JacobsFarm/sow_machine/CAD_design/stepper_motor/previews/4_from_below.png

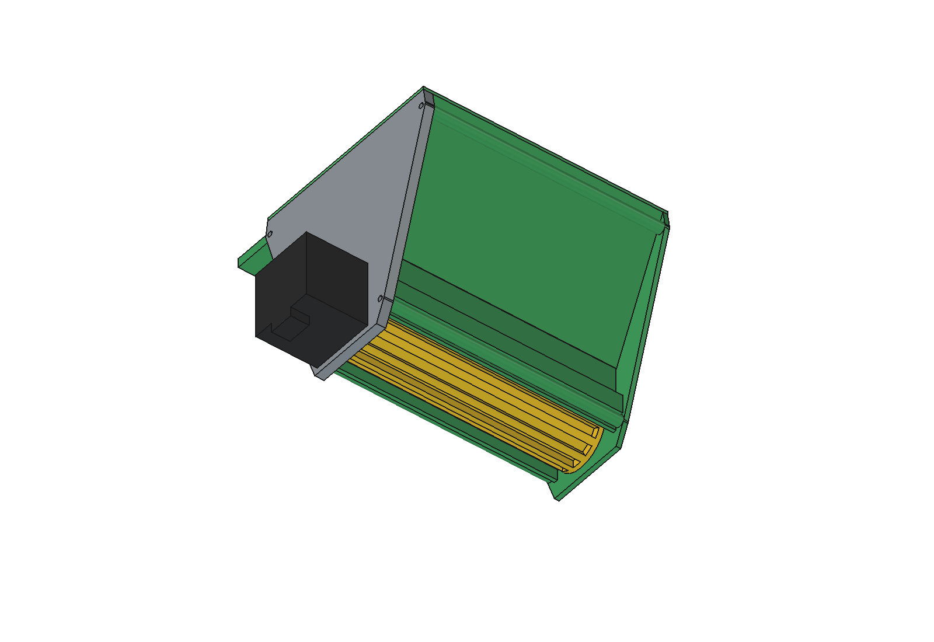
CAD_design/stepper_motor/previews/4_from_below.png
