JacobsFarm/sow_machine/CAD_design/TT-motor/previews/image-1792515938362.png

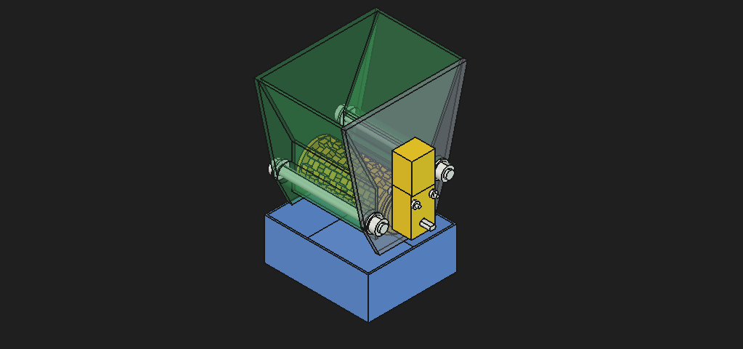
CAD_design/TT-motor/previews/image-1792515938362.png
