JacobsFarm/sow_machine/CAD_design/stepper_motor/Overseeder_Mini_Print.step

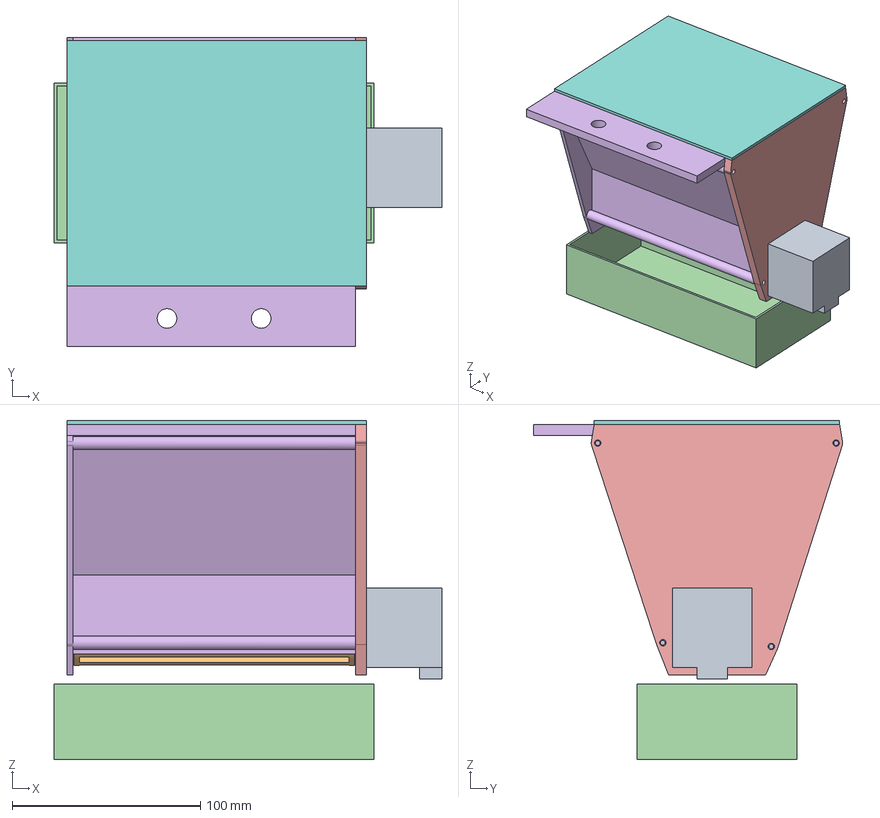
[picture p16: CAD file, 2026-10-20]
CAD_design/stepper_motor/Overseeder_Mini_Print.step
206.0 x 164.3 x 180.0 mm
stepper_NEMA17_42x40
fluted_roller_D40_12_flutes_PETG
stepper_shaft_D5
catch_tray_PETG
motor_plate_PETG
hopper_body_PETG
cutoff_rim_PETG
lid_PETG
