JacobsFarm/sow_machine/CAD_design/TT-motor/Overseeder_Mini_TT.step

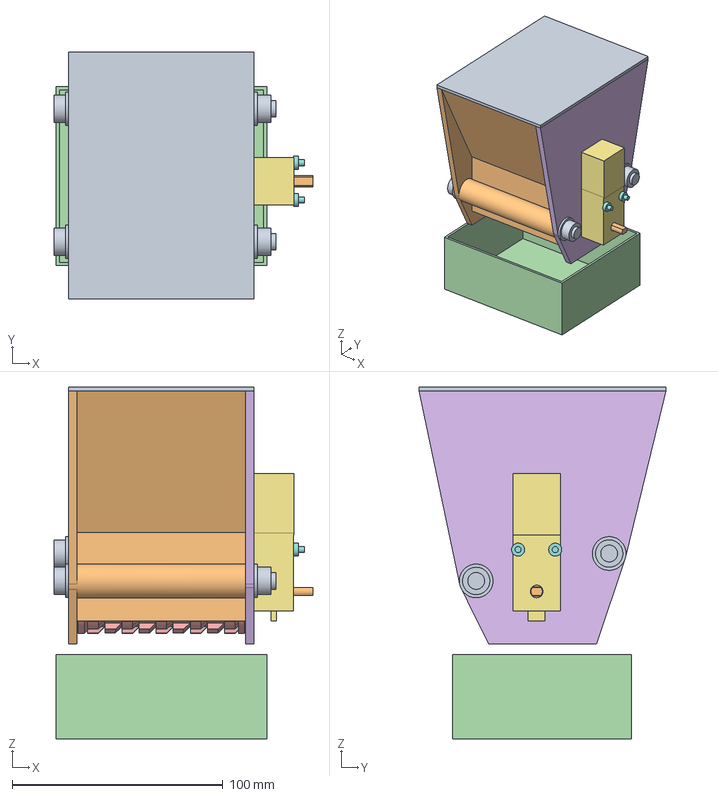
[picture p18: CAD file, 2026-10-20]
CAD_design/TT-motor/Overseeder_Mini_TT.step
122.8 x 117.1 x 167.0 mm
lid_PETG
TT_shaft_5.4_DD_3.7
cutoff_rim_PETG
catch_tray_PETG
cam_roller_F_TT_PETG
motor_plate_TT_PETG
TT_gear_motor_1to48
motor_bolts_M3x25_nuts
bolt_M8x100_washers_nut
hopper_body_PETG
