JacobsFarm/sow_machine/CAD_design/TT-motor/stl/ovt_roller_F.stl

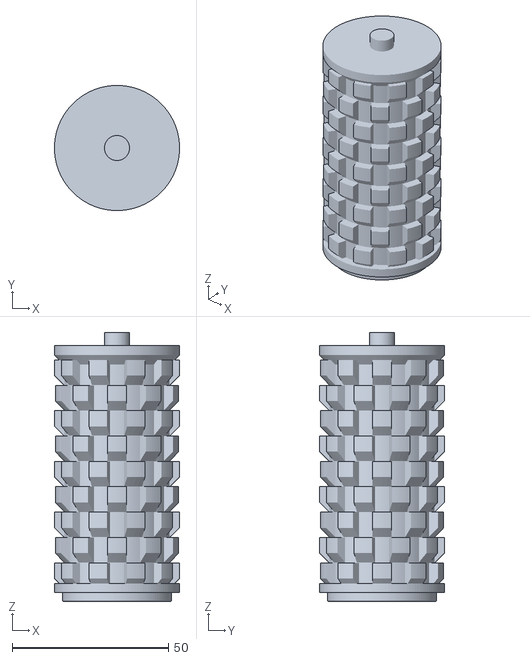
[picture p19: CAD file, 2026-10-20]
CAD_design/TT-motor/stl/ovt_roller_F.stl
40.0 x 40.0 x 86.0
