JacobsFarm/sow_machine/code/TT-motor/app/models/rim.stl

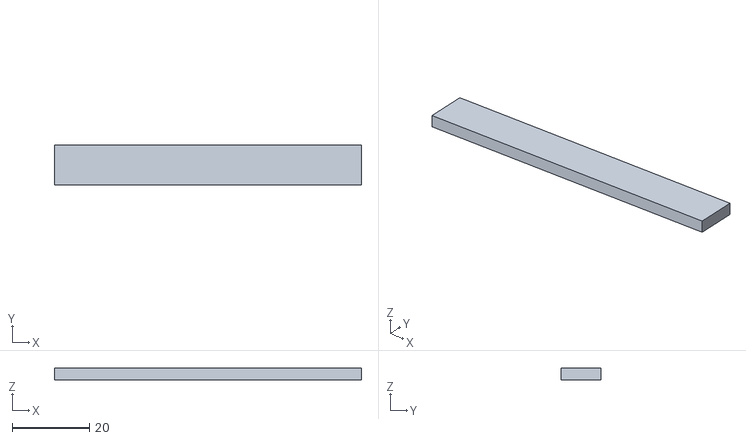
[picture p20: CAD file, 2026-10-20]
code/TT-motor/app/models/rim.stl
79.6 x 10.5 x 3.00
