JacobsFarm/sow_machine/code/TT-motor/app/models/roller_E.stl

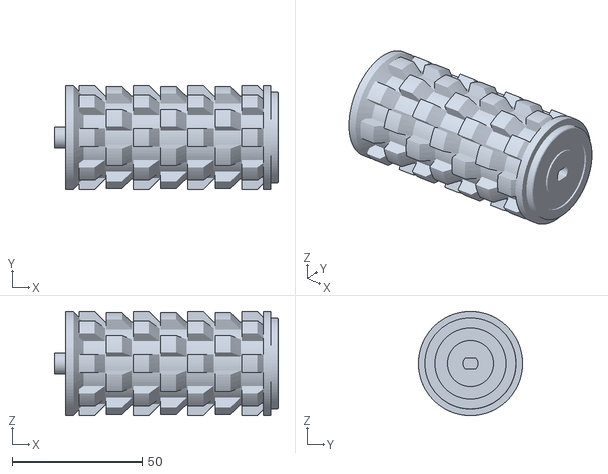
[picture p22: CAD file, 2026-10-20]
code/TT-motor/app/models/roller_E.stl
86.0 x 40.0 x 40.0
