JacobsFarm/sow_machine/CAD_design/stepper_motor/stl/ovm_tray.stl

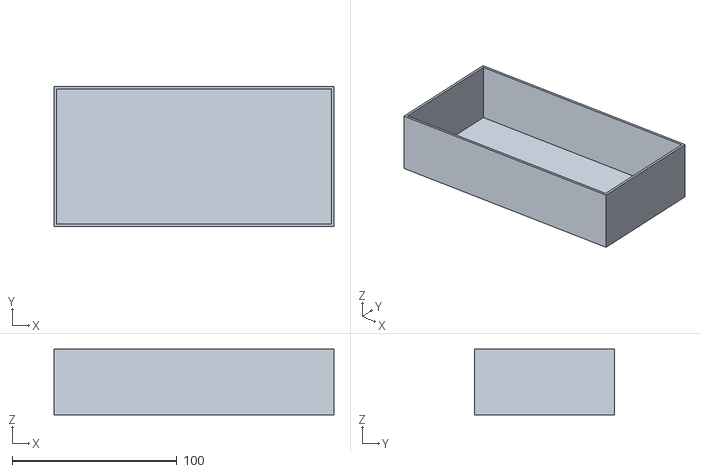
[picture p23: CAD file, 2026-10-20]
CAD_design/stepper_motor/stl/ovm_tray.stl
170.0 x 85.0 x 40.0
