JacobsFarm/sow_machine/CAD_design/stepper_motor/stl/ovm_rim.stl

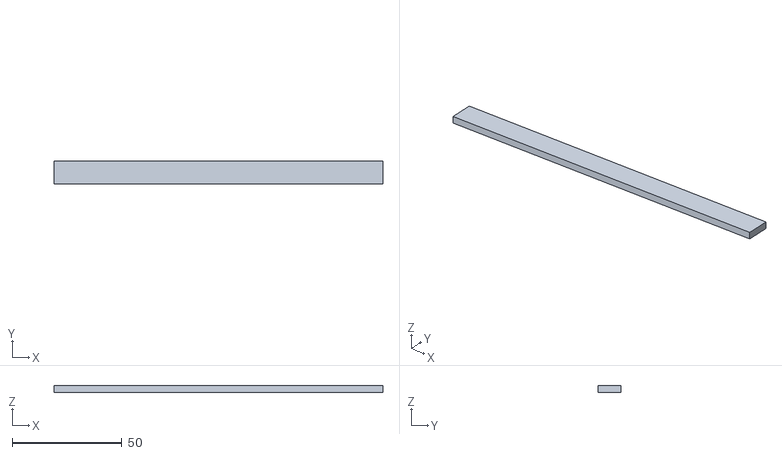
[picture p24: CAD file, 2026-10-20]
CAD_design/stepper_motor/stl/ovm_rim.stl
149.6 x 10.5 x 3.00
