JacobsFarm/sow_machine/CAD_design/TT-motor/stl/ovt_lid.stl

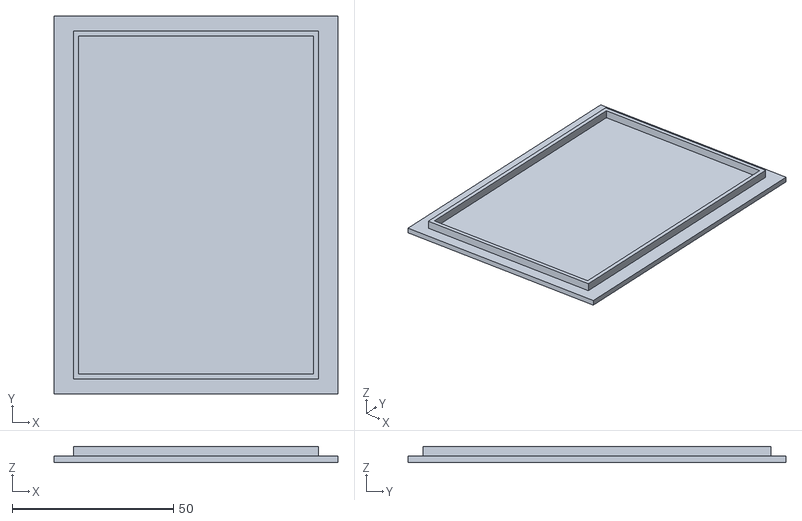
[picture p25: CAD file, 2026-10-20]
CAD_design/TT-motor/stl/ovt_lid.stl
88.0 x 117.1 x 5.00
