JacobsFarm/sow_machine/CAD_design/stepper_motor/stl/ovm_lid.stl

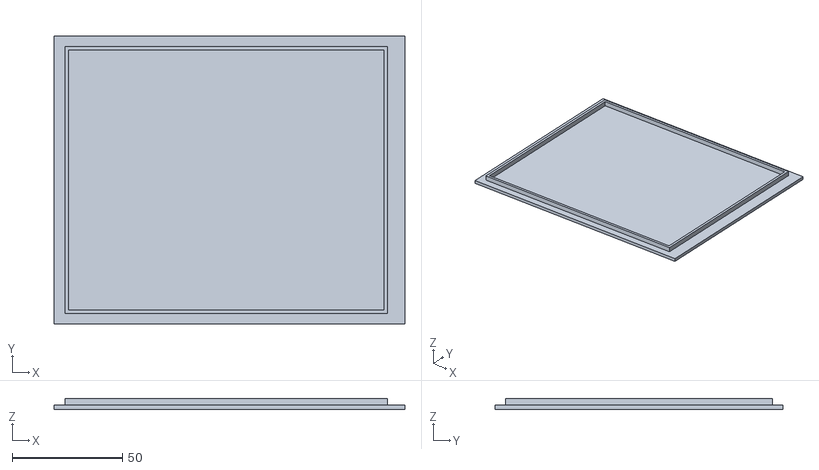
[picture p26: CAD file, 2026-10-20]
CAD_design/stepper_motor/stl/ovm_lid.stl
159.0 x 130.3 x 5.00
