JacobsFarm/sow_machine/CAD_design/stepper_motor/stl/ovm_roller.stl

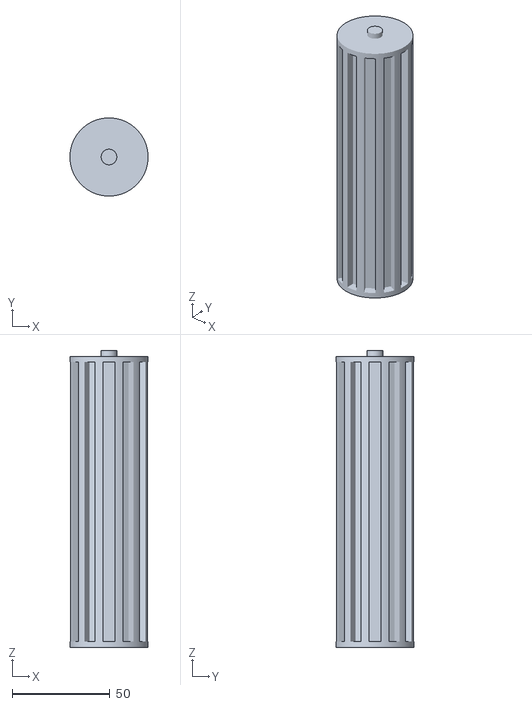
[picture p27: CAD file, 2026-10-20]
CAD_design/stepper_motor/stl/ovm_roller.stl
40.0 x 40.0 x 152.0
