JacobsFarm/sow_machine/CAD_design/stepper_motor/stl/ovm_roller_G.stl

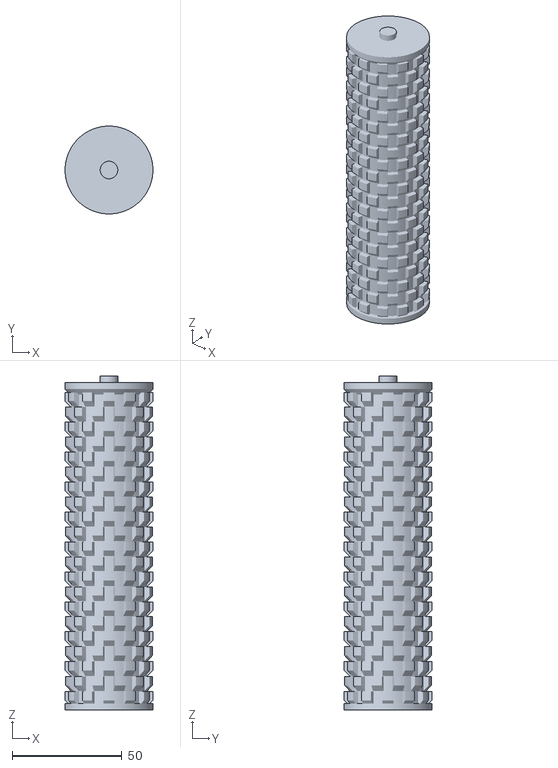
[picture p28: CAD file, 2026-10-20]
CAD_design/stepper_motor/stl/ovm_roller_G.stl
40.0 x 40.0 x 152.0
