JacobsFarm/sow_machine/code/TT-motor/app/models/tt_shaft.stl

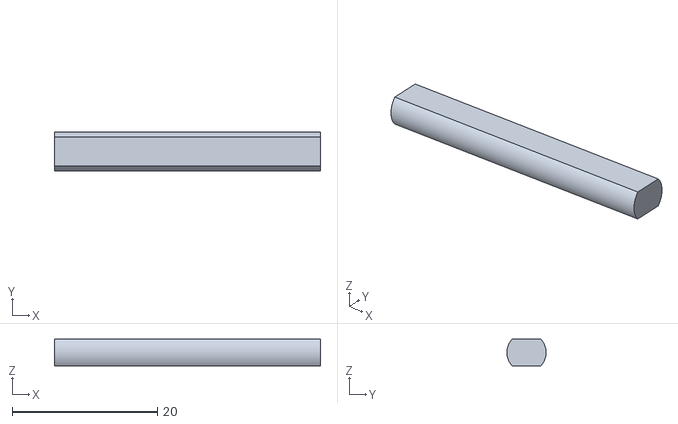
[picture p29: CAD file, 2026-10-20]
code/TT-motor/app/models/tt_shaft.stl
36.6 x 5.40 x 3.70
