JacobsFarm/sow_machine/CAD_design/stepper_motor/stl/ovm_body.stl

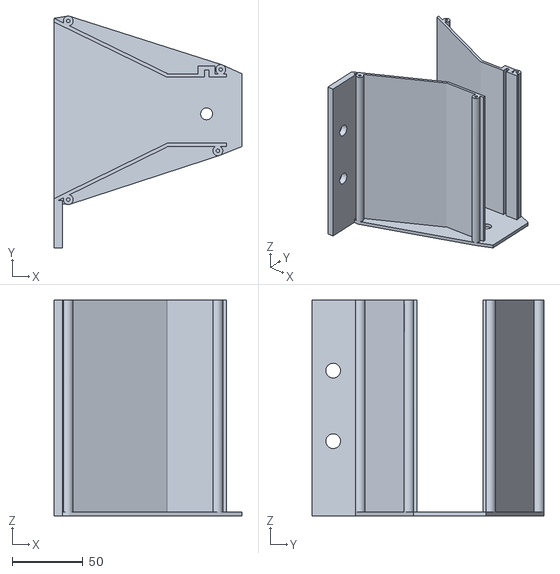
[picture p30: CAD file, 2026-10-20]
CAD_design/stepper_motor/stl/ovm_body.stl
133.0 x 164.3 x 153.0
