JacobsFarm/sow_machine/CAD_design/TT-motor/stl/ovt_tray.stl

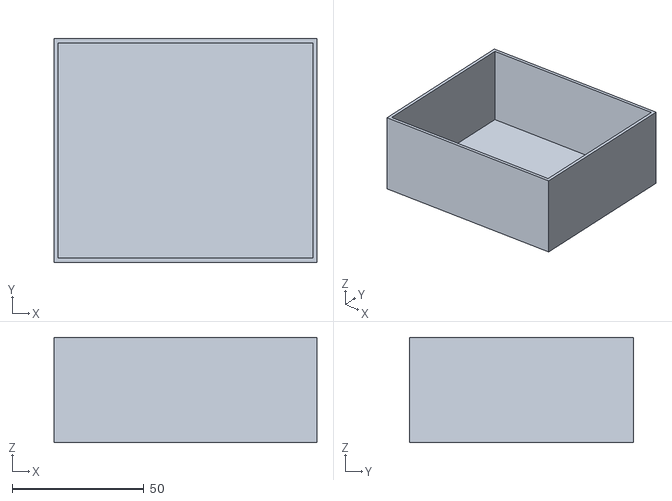
[picture p31: CAD file, 2026-10-20]
CAD_design/TT-motor/stl/ovt_tray.stl
100.0 x 85.0 x 40.0
