JacobsFarm/sow_machine/code/TT-motor/app/models/motor_plate.stl

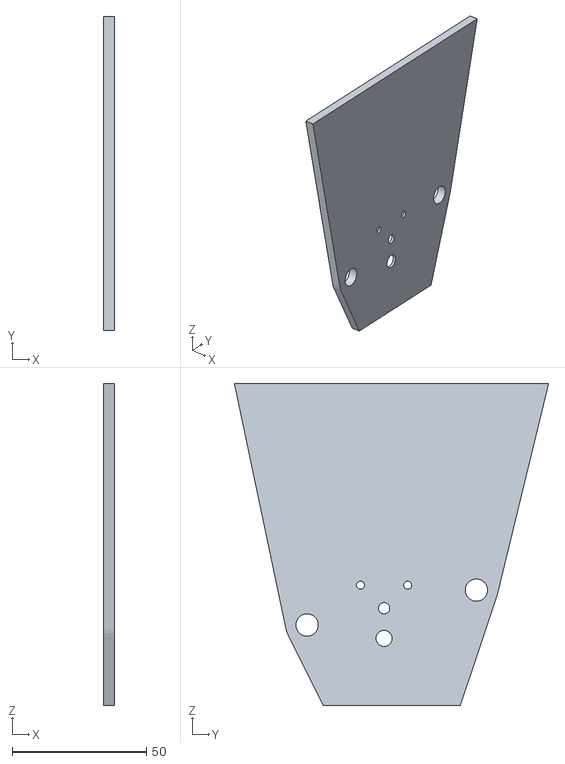
[picture p32: CAD file, 2026-10-20]
code/TT-motor/app/models/motor_plate.stl
4.00 x 117.1 x 120.0
