JacobsFarm/sow_machine/CAD_design/TT-motor/stl/ovt_body.stl

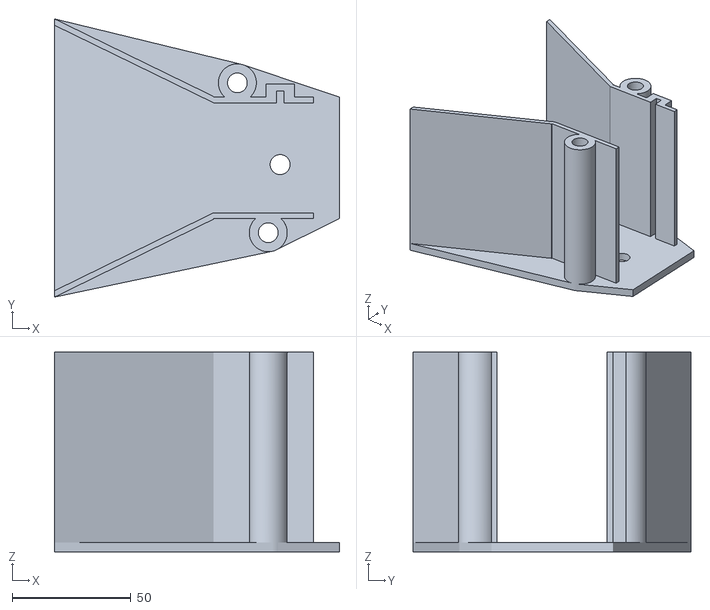
[picture p34: CAD file, 2026-10-20]
CAD_design/TT-motor/stl/ovt_body.stl
120.0 x 117.1 x 84.0
