JacobsFarm/sow_machine/CAD_design/stepper_motor/stl/ovm_motor_plate.stl

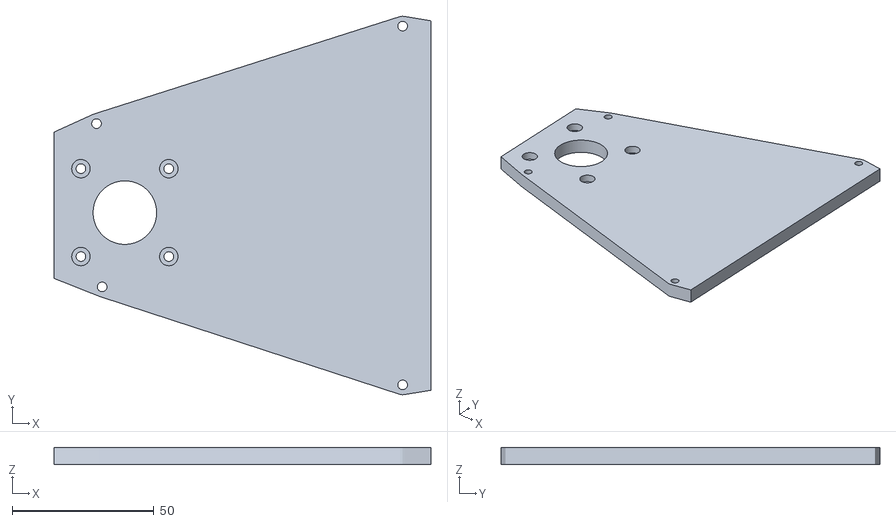
[picture p35: CAD file, 2026-10-20]
CAD_design/stepper_motor/stl/ovm_motor_plate.stl
133.0 x 133.6 x 6.00
