JacobsFarm/sow_machine/code/TT-motor/app/models/tt_motor.stl

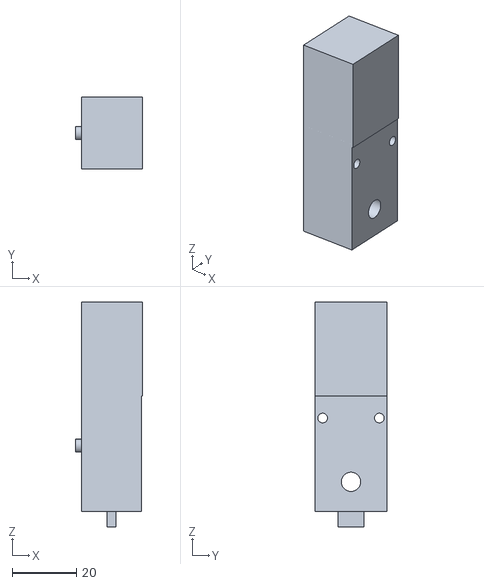
[picture p36: CAD file, 2026-10-20]
code/TT-motor/app/models/tt_motor.stl
20.9 x 22.4 x 70.0
