JacobsFarm/sow_machine/CAD_design/stepper_motor/stl/ovm_roller_B.stl

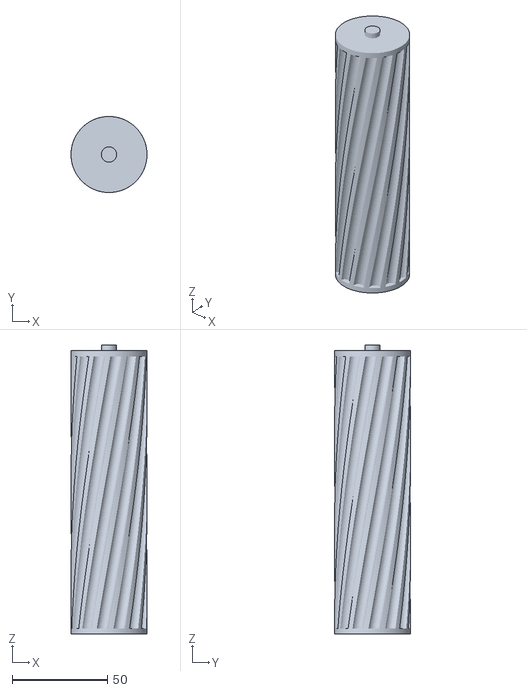
[picture p37: CAD file, 2026-10-20]
CAD_design/stepper_motor/stl/ovm_roller_B.stl
40.0 x 40.0 x 152.0
