JacobsFarm/sow_machine/(list of files, cad)

Other CAD files:
CAD_design/TT-motor/stl/ovt_rim.stl
CAD_design/TT-motor/stl/ovt_roller_D.stl
code/TT-motor/app/models/roller_F.stl
CAD_design/TT-motor/stl/ovt_roller_H.stl
code/TT-motor/app/models/roller_I.stl
CAD_design/stepper_motor/stl/ovm_roller_F.stl
code/TT-motor/app/models/roller_D.stl
CAD_design/TT-motor/stl/ovt_roller_I.stl
code/TT-motor/app/models/roller_H.stl
CAD_design/TT-motor/stl/ovt_roller_G.stl
code/TT-motor/app/models/roller_G.stl
CAD_design/TT-motor/stl/ovt_roller_E.stl
code/TT-motor/app/models/body.stl
CAD_design/TT-motor/stl/ovt_motor_plate.stl
CAD_design/stepper_motor/stl/ovm_roller_E.stl
CAD_design/TT-motor/Overseeder_Mini_TT.FCStd
CAD_design/stepper_motor/Overseeder_Mini_Print.FCStd
