JacobsFarm/sow_machine/CAD_design/stepper_motor/build_ovm.py

"""Model of the mini drop seeder for 3D printing: hopper, fluted or cam roller, cut-off rim, motor plate, lid,
catch tray, NEMA 17 stepper.

Use in FreeCAD (folder on sys.path, or via run_in_freecad.py):
    import build_ovm
    build_ovm.build()                   # saves FCStd and STEP
    build_ovm.check_interference()      # must be empty (the rim does not touch the roller)
    build_ovm.check_variants()          # check_interference() with each roller variant A..H (P.ROLLERS)
    build_ovm.check_fit()               # every printed part on the bed in its print orientation: must be empty
    build_ovm.mass_properties()         # filament per part, total, cost
    build_ovm.roller_variants()         # filament and modelled flute volume per roller variant vs ovm_calc
    build_ovm.export_stl()              # stl/<part>.stl and stl/ovm_roller_<B..H>.stl, in the print orientation
    build_ovm.set_roller(30)            # turn the roller (degrees, + = the top moves forward)
    build_ovm.render_all()

Stands on its own (no robot model): local frame of ovm_params, origin = roller axis.
"""
import os

import FreeCAD as App
import Part
from FreeCAD import Vector as V

import ovm_params as P
import ovm_parts as G

FOLDER = os.path.dirname(os.path.abspath(__file__))
PREVIEW_DIR = os.path.join(FOLDER, "previews")
STL_DIR = os.path.join(FOLDER, "stl")
DOC_NAME = "Overseeder_Mini_Print"
SAVE_BASE = os.path.join(FOLDER, "Overseeder_Mini_Print")
ROOT = "Overseeder_mini"
METER = "Meter"

COLOR = {
    "body": (0.20, 0.62, 0.32),
    "plate": (0.55, 0.57, 0.60),
    "roller": (0.95, 0.75, 0.10),
    "rim": (0.08, 0.08, 0.08),
    "lid": (0.30, 0.75, 0.42),
    "tray": (0.35, 0.55, 0.85),
    "motor": (0.12, 0.12, 0.13),
    "shaft": (0.75, 0.75, 0.78),
}

# name: (function, label, color, material density or None for bought, print rotation (axis, degrees))
PARTS = {
    "body": (G.body, "hopper_body_PETG", "body", P.petg, ((0, 1, 0), -90.0)),
    "motor_plate": (G.motor_plate, "motor_plate_PETG", "plate", P.petg, ((0, 1, 0), 90.0)),
    "roller": (G.roller, "fluted_roller_D40_12_flutes_PETG", "roller", P.petg, ((0, 1, 0), 90.0)),
    "rim": (G.rim, "cutoff_rim_PETG", "rim", P.petg, ((0, 0, 1), 0.0)),
    "lid": (G.lid, "lid_PETG", "lid", P.petg, ((1, 0, 0), 180.0)),
    "tray": (G.tray, "catch_tray_PETG", "tray", P.petg, ((0, 0, 1), 0.0)),
    "stepper": (G.stepper, "stepper_NEMA17_42x40", "motor", None, None),
    "stepper_shaft": (G.stepper_shaft, "stepper_shaft_D5", "shaft", None, None),
}
VARIANTS = [k for k in P.ROLLERS if k != P.ROLLER_DEFAULT]     # extra rollers: stl/ovm_roller_<k>.stl
TOUCHING = {("stepper", "stepper_shaft")}   # one motor, shaft drawn separately so it turns with the roller


# ---------------------------------------------------------------------
# Tree
# ---------------------------------------------------------------------
def new_part(doc, parent, name, label, placement=None):
    part = doc.addObject("App::Part", name)
    part.Label = label
    if placement is not None:
        part.Placement = placement
    if parent is not None:
        parent.addObject(part)
    return part


def add_shape(doc, parent, name, shape, visible=True):
    _, label, color, _, _ = PARTS[name]
    obj = doc.addObject("Part::Feature", name)
    obj.Label = label
    obj.Shape = shape
    parent.addObject(obj)
    if obj.ViewObject is not None:
        obj.ViewObject.ShapeColor = COLOR[color]
        obj.ViewObject.Visibility = visible
    return obj


def build(save=True, step=True):
    if DOC_NAME in App.listDocuments():
        App.closeDocument(DOC_NAME)
    doc = App.newDocument(DOC_NAME)
    doc.Label = "Overseeder mini print"
    doc.Comment = ("Generated by build_ovm.py from ovm_params.py. Local frame: x = along the roller, y = forward, "
                   "z = up, origin = roller axis.")
    root = new_part(doc, None, ROOT, "overseeder_mini_drop_seeder_3d_print")
    hop = new_part(doc, root, "Hopper", "hopper")
    for n in ("body", "lid", "rim"):
        add_shape(doc, hop, n, PARTS[n][0]())
    drv = new_part(doc, root, "Drive", "drive_nema17")
    for n in ("motor_plate", "stepper"):
        add_shape(doc, drv, n, PARTS[n][0]())
    spin = new_part(doc, root, METER, "meter_roller_rotates")
    add_shape(doc, spin, "roller", G.roller())
    add_shape(doc, spin, "stepper_shaft", G.stepper_shaft())
    calib = new_part(doc, root, "Calibration", "calibration")
    add_shape(doc, calib, "tray", G.tray())
    doc.recompute()
    if save:
        doc.saveAs(SAVE_BASE + ".FCStd")
    if step:
        export_step(doc, SAVE_BASE + ".step")
    return doc


def active_doc(doc=None):
    if doc is not None:
        return doc
    if DOC_NAME in App.listDocuments():
        return App.getDocument(DOC_NAME)
    raise RuntimeError("build_ovm.build() first")


def objects(doc):
    return [o for o in doc.getObject(ROOT).OutListRecursive if o.TypeId == "Part::Feature"]


def global_shape(obj):
    s = obj.Shape.copy()
    s.Placement = obj.getGlobalPlacement()
    return s


def set_roller(angle_deg, doc=None):
    """Turn the roller (+ = the top moves forward, +y; the front side moves down past the lip)."""
    doc = active_doc(doc)
    doc.getObject(METER).Placement = App.Placement(V(0, 0, 0), App.Rotation(V(1, 0, 0), -angle_deg))
    doc.recompute()


def export_step(doc, path):
    import Import
    Import.export(objects(doc), path)


# ---------------------------------------------------------------------
# Checks
# ---------------------------------------------------------------------
def check_interference(doc=None, tol=0.5, angles=(0.0, 7.5, 15.0)):
    """Volume overlap (mm3) between all parts, at a few roller angles (the flutes or cams pass the rim)."""
    doc = active_doc(doc)
    hits = []
    for a in angles:
        set_roller(a, doc)
        objs = [(o, global_shape(o)) for o in objects(doc)]
        for i in range(len(objs)):
            for j in range(i + 1, len(objs)):
                (oa, sa), (ob, sb) = objs[i], objs[j]
                if not sa.BoundBox.intersect(sb.BoundBox):
                    continue
                vol = sa.common(sb).Volume
                if vol <= tol:
                    continue
                key = tuple(sorted((oa.Name, ob.Name)))
                if key in TOUCHING:
                    continue
                hits.append((a, oa.Label, ob.Label, round(vol, 1)))
    set_roller(0.0, doc)
    return {"hits": hits}


def set_variant(variant, doc=None):
    """Put roller variant k (P.ROLLERS) in the model, for the checks; build() always puts in the default."""
    doc = active_doc(doc)
    o = doc.getObject("roller")
    o.Shape = G.roller(variant)
    o.Label = "roller_%s_%s_PETG" % (variant, P.ROLLERS[variant]["label"].replace(" ", "_").replace(",", ""))
    doc.recompute()


def check_variants(doc=None):
    """check_interference() with every roller variant in turn, at angles over one flute / stud pitch."""
    doc = active_doc(doc)
    out = {}
    for k in P.ROLLERS:
        set_variant(k, doc)
        out[k] = check_interference(doc, angles=(0.0, 6.4, 12.9, 19.3))
    set_variant(P.ROLLER_DEFAULT, doc)
    doc.getObject("roller").Label = PARTS["roller"][1]
    return out


def part_shape(name):
    """Shape of a part; 'roller_<k>' is roller variant k (P.ROLLERS), 'roller' the default."""
    if name.startswith("roller_"):
        return G.roller(name.split("_", 1)[1])
    return PARTS[name][0]()


def part_spec(name):
    return PARTS["roller" if name.startswith("roller_") else name]


def print_shape(name):
    """The part rotated into its print orientation, standing on z = 0 and centred on the bed."""
    s = part_shape(name)
    axis, deg = part_spec(name)[4]
    s.rotate(V(0, 0, 0), V(*axis), deg)
    bb = s.optimalBoundingBox()   # exact: BoundBox of the swept flutes is loose
    s.translate(V(-(bb.XMin + bb.XMax) / 2.0, -(bb.YMin + bb.YMax) / 2.0, -bb.ZMin))
    return s


def printed():
    return [n for n, v in PARTS.items() if v[3] is not None]


def printed_all():
    """Printed parts plus the extra roller variants."""
    return printed() + ["roller_%s" % k for k in VARIANTS]


def check_fit():
    """Printed parts (and roller variants) that do not fit the bed (P.bed) in the print orientation: must be
    empty."""
    bx, by, bz = P.bed
    out = {}
    for n in printed_all():
        bb = print_shape(n).optimalBoundingBox()
        xy = sorted((bb.XLength, bb.YLength))
        if not (xy[0] <= min(bx, by) and xy[1] <= max(bx, by) and bb.ZLength <= bz):
            out[n] = (round(bb.XLength), round(bb.YLength), round(bb.ZLength))
    return out


def print_sizes():
    out = {}
    for n in printed_all():
        bb = print_shape(n).optimalBoundingBox()
        out[n] = (round(bb.XLength), round(bb.YLength), round(bb.ZLength))
    return out


def roller_variants():
    """Per roller variant: filament (g) and the modelled flute / cell volume (cm3, the empty space inside Ø40 over
    the fluted length) against ovm_calc.volume_per_rev, to check the calculation against the solid."""
    import ovm_calc
    a, b = P.studded_span()
    envelope = G.cyl_x(P.roller_d, a, b)
    out = {}
    for k in P.ROLLERS:
        s = G.roller(k)
        plug = G.cyl_x(P.d_socket[0] + 1, P.roller_x[1] - P.d_socket[2] - 1, P.roller_x[1])   # fill the D socket
        model = envelope.Volume - s.fuse(plug).common(envelope).Volume
        calc = ovm_calc.volume_per_rev(k)
        out[k] = {"g": round(s.Volume * P.petg * P.infill_eff, 1), "cm3_model": round(model / 1000.0, 2),
                  "cm3_calc": round(calc / 1000.0, 2), "diff_pct": round(100.0 * (model - calc) / calc, 2),
                  "valid": s.isValid(), "solids": len(s.Solids)}
    return out


def mass_properties():
    """Filament per printed part (solid volume x density x infill_eff), total and cost; plus the stepper."""
    parts, total = {}, 0.0
    for n in printed():
        fn, _, _, dens, _ = PARTS[n]
        g = fn().Volume * dens * P.infill_eff
        parts[n] = round(g, 1)
        total += g
    return {"parts_g": parts, "printed_g": round(total), "stepper_g": round(P.stepper_kg * 1000),
            "rig_g": round(total + P.stepper_kg * 1000 - parts["tray"]),
            "filament_eur": round(total / 1000.0 * P.filament_eur_kg, 2)}


def export_stl(folder=STL_DIR, deflection=0.02, helical=(0.05, 0.2)):
    """STL per printed part in the print orientation. The swept helical flutes mesh to 11 - 14 MB at 0.02 mm /
    0.1 rad; 'helical' (linear mm, angular rad) gives about 3 MB at 0.1 % volume difference."""
    import MeshPart
    os.makedirs(folder, exist_ok=True)
    out = []
    for n in printed_all():
        lin, ang = deflection, 0.1
        if n.startswith("roller_") and P.ROLLERS[n.split("_", 1)[1]]["kind"] == "helical":
            lin, ang = helical
        mesh = MeshPart.meshFromShape(Shape=print_shape(n), LinearDeflection=lin, AngularDeflection=ang,
                                      Relative=False)
        path = os.path.join(folder, "ovm_%s.stl" % n)
        mesh.write(path)
        out.append(path)
    return out


# ---------------------------------------------------------------------
# Images
# ---------------------------------------------------------------------
def save_view(name, direction, target=(0, 0, 40), height=None, up=(0.0, 0.0, 1.0), size_px=(1600, 1100)):
    import FreeCADGui as Gui
    from pivy import coin
    Gui.updateGui()
    view = Gui.ActiveDocument.ActiveView
    view.setCameraType("Orthographic")
    d = V(*direction)
    d.normalize()
    cam = view.getCameraNode()
    tgt = V(*target)
    eye = tgt - d * 2000.0
    cam.position.setValue(coin.SbVec3f(eye.x, eye.y, eye.z))
    cam.pointAt(coin.SbVec3f(tgt.x, tgt.y, tgt.z), coin.SbVec3f(*up))
    cam.nearDistance.setValue(1.0)
    cam.farDistance.setValue(5000.0)
    if height is None:
        view.fitAll()
    else:
        cam.height.setValue(height)
    Gui.updateGui()
    os.makedirs(PREVIEW_DIR, exist_ok=True)
    path = os.path.join(PREVIEW_DIR, name)
    view.saveImage(path, size_px[0], size_px[1], "White")
    return path


def set_visible(doc, names, visible):
    for n in names:
        o = doc.getObject(n)
        if o is not None:
            o.ViewObject.Visibility = visible


def explode(doc, offsets):
    for n, (dx, dy, dz) in offsets.items():
        o = doc.getObject(n)
        o.Placement = App.Placement(V(dx, dy, dz), App.Rotation())


EXPLODE = {"lid": (0, 0, 70), "motor_plate": (90, 0, 0), "stepper": (150, 0, 0), "rim": (0, 70, 0),
           "tray": (0, 0, -50)}


def render_all():
    import FreeCADGui as Gui
    out = []
    doc = build(save=False, step=False)
    out.append(save_view("1_iso.png", (-1.0, -1.1, -0.8), height=330))
    set_visible(doc, ("motor_plate", "stepper", "lid"), False)
    set_roller(7.5, doc)
    out.append(save_view("2_section_from_motor_side.png", (-1.0, 0.0, 0.0), target=(0, 0, 20), height=230))
    set_roller(0.0, doc)
    set_visible(doc, ("motor_plate", "stepper", "lid"), True)
    explode(doc, EXPLODE)
    set_visible(doc, ("rim",), True)
    doc.getObject(METER).Placement = App.Placement(V(45, 0, 0), App.Rotation())
    out.append(save_view("3_exploded.png", (-0.9, 1.0, -0.6), target=(60, 0, 30), height=420))
    explode(doc, {n: (0, 0, 0) for n in EXPLODE})
    doc.getObject(METER).Placement = App.Placement()
    set_visible(doc, ("tray",), False)
    out.append(save_view("4_from_below.png", (-0.7, -0.9, 1.0), height=330))
    App.closeDocument(doc.Name)
    out.append(render_print_layout())
    out.append(render_roller_variants())
    build()
    return out


def render_roller_variants():
    """All rollers standing side by side as printed (motor end down), A to H from left to right, with a letter
    in front of each."""
    import FreeCADGui as Gui
    name = "Overseeder_Mini_Rollers"
    if name in App.listDocuments():
        App.closeDocument(name)
    doc = App.newDocument(name)
    step = P.roller_d + 25.0
    for i, k in enumerate(P.ROLLERS):
        s = G.roller(k)
        s.rotate(V(0, 0, 0), V(0, 1, 0), 90.0)
        bb = s.optimalBoundingBox()
        s.translate(V(i * step - (bb.XMin + bb.XMax) / 2.0, -(bb.YMin + bb.YMax) / 2.0, -bb.ZMin))
        o = doc.addObject("Part::Feature", "roller_" + k)
        o.Shape = s
        o.ViewObject.ShapeColor = COLOR["roller"]
        try:
            import Draft
            t = Draft.make_text([k], App.Placement(V(i * step - 4, -P.roller_d, -18), App.Rotation(V(1, 0, 0), 90)))
            t.ViewObject.FontSize = 14
            t.ViewObject.TextColor = (0.0, 0.0, 0.0)
        except Exception:
            pass
    doc.recompute()
    Gui.updateGui()
    mid = (len(P.ROLLERS) - 1) / 2.0 * step
    Gui.Selection.clearSelection()
    path = save_view("6_roller_variants.png", (0.0, 1.0, -0.3), target=(mid, 0, 70),
                     height=len(P.ROLLERS) * step / 1.6 + 20, size_px=(1600, 1000))
    App.closeDocument(doc.Name)
    return path


def render_print_layout():
    """All printed parts in their print orientation side by side on z = 0."""
    import FreeCADGui as Gui
    if "Overseeder_Mini_Layout" in App.listDocuments():
        App.closeDocument("Overseeder_Mini_Layout")
    doc = App.newDocument("Overseeder_Mini_Layout")
    x = 0.0
    for n in printed():
        s = print_shape(n)
        bb = s.optimalBoundingBox()
        s.translate(V(x - bb.XMin, 0, 0))
        o = doc.addObject("Part::Feature", n)
        o.Shape = s
        o.ViewObject.ShapeColor = COLOR[PARTS[n][2]]
        x += bb.XLength + 25.0
    bed = doc.addObject("Part::Feature", "bed")
    bed.Shape = Part.makeBox(x, 260, 1, V(-15, -130, -1))
    bed.ViewObject.ShapeColor = (0.85, 0.85, 0.85)
    doc.recompute()
    Gui.updateGui()
    path = save_view("5_print_layout.png", (-0.5, 1.0, -0.8), target=(x / 2.0, 0, 40))
    App.closeDocument(doc.Name)
    return path
