JacobsFarm/sow_machine/(commit log)

2026-10-20 project start
    [Overseeder_Mini_Print.FCStd, Overseeder_Mini_Print.step, Overseeder_Mini_TT.FCStd, Overseeder_Mini_TT.step, ovm_body.stl, ovm_lid.stl, ovm_motor_plate.stl, ovm_rim.stl]
2026-10-20 test code 1
    [body.stl, motor_plate.stl, rim.stl, roller_D.stl, roller_E.stl, roller_F.stl, roller_G.stl, roller_H.stl]
